citrustiara/Force-Plate-PRO/images/loadCell.png

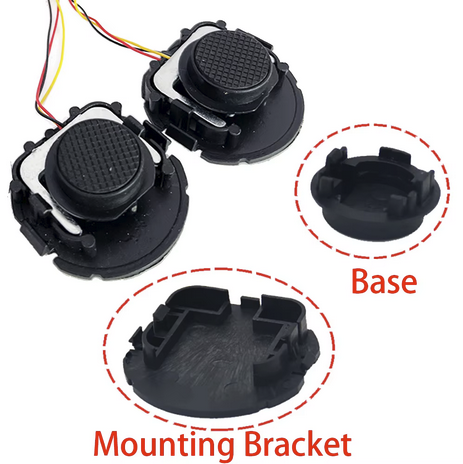
images/loadCell.png
