citrustiara/Force-Plate-PRO/images/top2.jpg

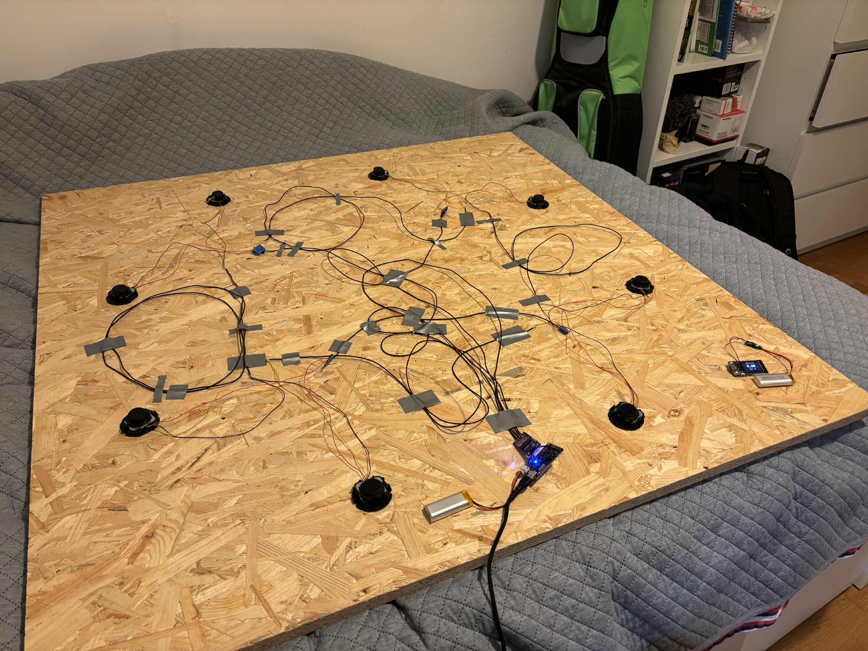
images/top2.jpg
