citrustiara/Force-Plate-PRO/(commit log)

2026-01-14 initial upload
    [20260110_488cm.ods]
2026-01-17 milion fixow i contact time tryb
    [database.py, main.py, physics.py]
2026-01-25 ui changes, physics bug fix
    [main.py, physics.py]
2026-01-29 refactoring and bug fixes
    [main.py, physics.py]
2026-01-30 jump not detected bug fix FINAL!!!!
    [main.py, physics.py]
2026-02-05 organizing, refactoring esp code, jump phases not showing fix
    [20260110_488cm.ods]
2026-02-05 drift compensation and readme update
    [physics.py]
2026-02-06 Revise wiring diagram caption in README
    Updated the caption for the wiring diagram to include an apology for the diagram quality. Github copilot suggested this message and desc.
2026-02-17 continuous mode prototype, menu options
